Normansrule/tiqora-skywater130/docs/HARDENING.md

# Hardening Tiqora

Everything in this file is work that has to happen on your machine, because
it needs the SkyWater sky130 process design kit (PDK) and a full
place-and-route flow. Simulation and lint are done; this is the part that
turns register-transfer level (RTL) code into a layout.

Order matters. Do not skip to step 4.

---

## What is already known, so you can check the tools against it

| Quantity | Value | Where it came from |
|---|---|---|
| Flip-flops | **1,191** flattened | `yosys -s syn/synth_check.ys`, exact (main 3684851, Yosys 0.33, 2026-10-27) |
| Generic cells before technology mapping | 7,416 | same run |
| Latches inferred | **0** | the `select -assert-none t:$dlatch` in that script |
| Self-checking simulation assertions | 495 in 18 suites, all passing | `cd test && make sim` (main 3684851, 2026-10-27) |
| Verilator `-Wall` | clean | `cd test && make lint` |

If your synthesis run disagrees with the flip-flop count by more than a few,
something is different about your setup and it is worth understanding before
you continue.

---

## Step 0 — versions, because this is where the time goes

```bash
yosys -V          # any version works
verilator --version
iverilog -V | head -1
```

Any Yosys will do. The RTL deliberately avoids both typedef'd enums on
ports and file-scope `import`, referring to package symbols as
`tp_pkg::NAME` instead, which every Yosys back to 0.33 parses. That was
not free — it means writing the prefix everywhere — but it removes a
whole class of "works on my machine" failure. If you want a newer Yosys
anyway:

```bash
pip install --break-system-packages yowasp-yosys
yowasp-yosys -V
# then substitute yowasp-yosys wherever this file says yosys
```

This is not a quirk of this project. Yosys's native Verilog frontend passes
roughly half of a standard SystemVerilog construct suite. The RTL here was
deliberately written to stay inside what it accepts — no typedef'd enums or
packed structs on ports or in declarations — precisely so you are not forced
to depend on the `yosys-slang` plugin being present in someone else's
continuous integration. If you ever add a `typedef enum` port to this
design, it will simulate perfectly and then fail to harden.

---

## Step 1 — prove it still passes before you spend an hour on layout

```bash
cd test
make lint         # Verilator -Wall, must be clean
make sim          # 495 checks across eighteen suites, plus the recorded tour
make area         # real sky130 area: cells, flip-flops, fit per tile size
cd ..
```

If any of those fail, stop. Hardening a broken design just gives you a
broken layout more slowly.

---

## Step 2 — install the hardening flow

Tiny Tapeout builds with LibreLane (the successor to OpenLane 2). Two ways
to get it; the container is less trouble on Windows Subsystem for Linux
(WSL2).

### Option A — Docker (recommended on WSL2)

Docker Desktop must be running on the Windows side with WSL2 integration
enabled for your distribution. Check from inside Ubuntu:

```bash
docker run --rm hello-world
```

Then:

```bash
pip install --break-system-packages librelane
```

LibreLane pulls its own container image on first run. The sky130 PDK is
fetched automatically into `~/.volare` the first time, which is a few
gigabytes and takes a while. Let it finish.

### Option B — Nix

```bash
sh <(curl -L https://nixos.org/nix/install) --daemon
# restart the shell, then
nix profile install github:efabless/librelane
```

Nix gives a reproducible toolchain and is what the LibreLane developers use.
It is also a larger initial download.

---

## Step 3 — harden the design

The Tiny Tapeout template supplies the configuration that pins your design
into a tile: the die area for the tile count, the pin placement the harness
expects, and the power straps. **Do not write your own floorplan.** Get the
template:

```bash
cd ~
git clone https://github.com/TinyTapeout/tt10-verilog-template.git tt-template
# use whichever shuttle template is current — check tinytapeout.com
```

Copy `src/`, `info.yaml`, `docs/` and `test/` from this repository over the
template's, keeping the template's `.github/`, `Makefile` and any
`*.json`/`*.tcl` configuration. Then:

```bash
cd ~/tt-template
make            # or follow the template's README; it wraps librelane
```

What actually runs, in order: Yosys synthesis, floorplanning, power
distribution network insertion, global and detailed placement, clock tree
synthesis, global and detailed routing, parasitic extraction, static timing
analysis, and finally GDSII streaming plus design-rule and
layout-versus-schematic checks.

Expect 10 to 40 minutes for a design this size.

### The easier route

Push to GitHub with Actions enabled and the Tiny Tapeout workflow does all
of this in continuous integration and publishes the GDSII, the reports and a
rendered datasheet page. Use that as the reference result and run locally
only when you need to iterate quickly or debug a failure.

---

## Step 4 — read the reports before you look at the picture

This is the step people skip. The layout renders beautifully whether or not
it meets timing.

```bash
cd runs/<latest>/
```

**Area and utilisation** — `reports/synthesis/*stat*.rpt` and the
floorplan log. What you want:

- The standard cell count and total cell area in µm².
- The core utilisation percentage. Above roughly 60–70% on a tile, detailed
  routing starts failing.

Compare the flip-flop count against the 1,191 this repository measured. It
should match closely; a large difference means a configuration difference.

**Timing** — `reports/signoff/*sta*.rpt` or the `openroad` STA logs. Look
for:

- **Worst negative slack (WNS)** on the setup path. Must be positive at your
  target clock period. Negative means the design does not run at that speed;
  either lower `clock_hz` in `info.yaml` or shorten the critical path.
- **Total negative slack (TNS)**. Should be zero.
- **Hold slack.** Must be positive. Hold violations are not fixable by
  slowing the clock and are the more dangerous kind.

The critical path should be the one this design was built around:
register file read → the 33-bit adder in `tp_alu` → writeback multiplexer
→ register file write. If static timing reports something else as critical —
the shifter, the branch comparator, the target adder — then an assumption in
the microarchitecture section of the README is wrong and worth investigating
rather than papering over.

**Design rule check (DRC) and layout versus schematic (LVS)** — must both be
clean. Zero violations, not "a few".

**Antenna violations** — the flow inserts diodes automatically. A handful of
reported-then-fixed ones are normal.

---

## Step 5 — open the layout in KLayout

```bash
sudo apt install klayout        # or download from klayout.de for a current build
klayout runs/<latest>/final/gds/tt_um_normansrule_tiqora.gds
```

KLayout needs the sky130 layer properties file to colour the layers
meaningfully. It ships with the PDK:

```
~/.volare/sky130A/libs.tech/klayout/tech/sky130A.lyp
```

Load it with **File → Load Layer Properties**, or start KLayout with the
technology already selected:

```bash
klayout -e -nn ~/.volare/sky130A/libs.tech/klayout/tech/sky130A.lyt \
        runs/<latest>/final/gds/tt_um_normansrule_tiqora.gds
```

### What to actually look at

Opening the GDS is satisfying and mostly not informative. Four things are
worth checking with your eyes:

1. **The outline.** Your design must sit inside the tile boundary with the
   power rails reaching the edges where the harness expects them. Anything
   poking outside means a floorplan configuration mismatch.
2. **Density.** Pan around at moderate zoom. You are looking for large empty
   regions next to congested ones, which means placement struggled. Even
   density is what you want.
3. **The register file.** It is 480 flip-flops, 40% of the design, and it
   will be visible as a large regular block. If it is smeared across the
   whole tile rather than clustered, routing is probably fighting it.
4. **Routing congestion on metal 1 and metal 2.** Turn off the upper metals
   and look for areas where the lower layers are completely full.

Useful KLayout operations:

- **Tools → DRC** runs a rule deck if you load one; the flow has already
  done this, so this is for spot checks.
- **Display → Layers** to isolate a single metal layer.
- The **hierarchy browser** (left panel) lets you jump to an instance by
  name, which is how you find `u_soc.g_cpu.u_core.u_rf`.
- **Edit → Layer → Flatten** only on a copy; never flatten the file you plan
  to submit.

### Measuring the area yourself

In KLayout, **Tools → Measure** gives you the bounding box. Compare against
the tile pitch: sky130 tiles are about 161 µm by 112 µm for 1x1, a 2x2
is roughly 335 µm by 226 µm, and Tiqora's 3x2 is 508.76 µm by 225.76 µm. If your design's bounding box is comfortably
inside, consider whether a smaller tile count would have fit — each step
down is real money.

---

## Step 6 — gate-level simulation

The flow writes a post-layout netlist. Simulating it catches things RTL
simulation cannot: an inverted reset, a synthesis mis-optimisation, a
timing-dependent bug.

```bash
# the netlist is usually at:
runs/<latest>/final/nl/tt_um_normansrule_tiqora.nl.v
```

Run the cocotb tests against it. They drive the chip only through its pins,
so they work on any netlist:

```bash
cp runs/<latest>/final/nl/tt_um_normansrule_tiqora.nl.v test/gate_level_netlist.v
cd test && make GATES=yes PDK_ROOT=~/pdk
```

This is exactly what Tiny Tapeout's `test` workflow does with the hardened
netlist. Before hardening, `make gl` does the same with a netlist synthesized
locally from your PDK: 5 tests pass and 1 (which needs internal signals) is
skipped.

---

## Step 7 — before you submit

- [ ] `make lint` clean
- [ ] `make sim` — 495 checks passing, plus the recorded tour (15)
- [ ] `make area` — area and flip-flop count as expected
- [ ] Hardening completes with no DRC and no LVS violations
- [ ] Setup worst negative slack positive at the clock in `info.yaml`
- [ ] Hold slack positive
- [ ] `tiles` in `info.yaml` matches what actually fit
- [ ] Gate-level tests passing (`make gl` locally, `make GATES=yes` on the post-layout netlist)
- [ ] `docs/info.md` describes what the chip really does
- [ ] Pinout in `info.yaml` matches `src/tt_um_normansrule_tiqora.sv`

That last one is worth double-checking by hand. The pinout in `info.yaml` is
what gets printed on the datasheet other people read; nothing checks it
against the RTL.

---

## If it does not fit

The flip-flop budget, by module (Yosys, hierarchy kept; 1,190 in total):

| Module | Flip-flops | Share |
|---|---:|---:|
| `tp_nregfile` (15 × 32-bit registers) | 480 | 40% |
| `tp_ncore` | 147 | 12% |
| `qspi_ctrl` | 120 | 10% |
| `sync_compare` (2 channels) | 114 | 10% |
| `sync_timebase` | 81 | 7% |
| `sync_event_fifo` (2 entries) | 70 | 6% |
| `sync_unit` | 60 | 5% |
| `tp_uart` | 60 | 5% |
| `tp_periph` | 28 | 2% |
| `sync_capture` (8 channels) | 24 | 2% |
| `tp_soc`, `tp_bus` | 6 | 1% |

Knobs, all parameters of `tp_soc`, cheapest first:

1. **`FRACW` from 24 to 16**: 8 flip-flops, and the rate trim resolution goes
   from 0.06 to 15 parts per million. Only worth it if you are not
   disciplining the clock.
2. **`NCH` from 8 to 4 capture channels**: about 12 flip-flops plus the
   per-channel edge logic.
3. **`NCMP` from 2 to 1 trigger channel**: about 57 flip-flops. You lose TRIG1.

`DEPTH` (the event queue) is already at its useful minimum of 2. The register
file is the largest block, but RV32E fixes it at 15 registers and the stock
compilers assume all of them, so it is not a knob. If routing still fails,
the honest fix is a bigger tile: 3 × 2 costs 140 € more and leaves ample room.
