Normansrule/tiqora-skywater130/docs/images/explorer/tour.png

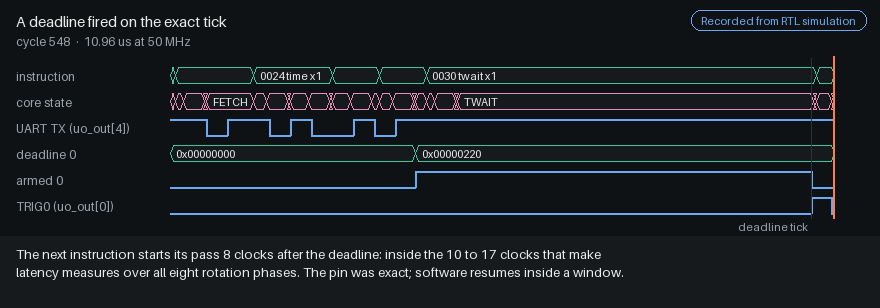
docs/images/explorer/tour.png
