Normansrule/tiqora-skywater130/docs/images/layout.png

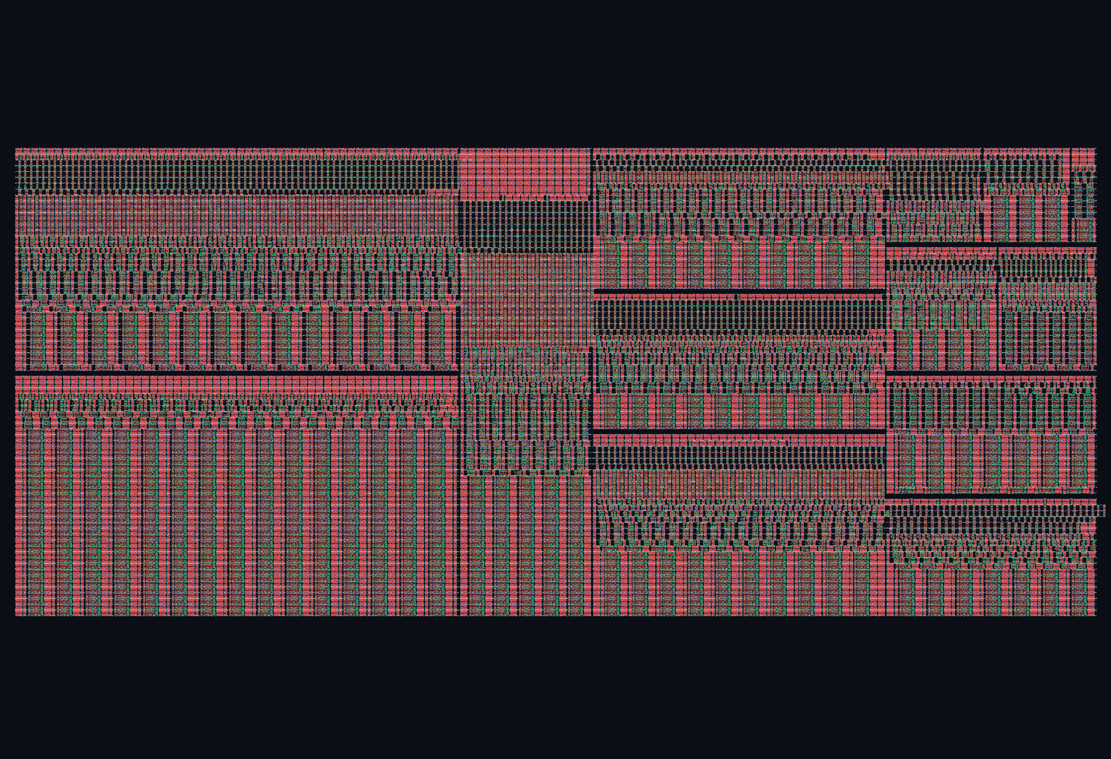
docs/images/layout.png
