Normansrule/tiqora-skywater130/docs/images/routed_clock.png

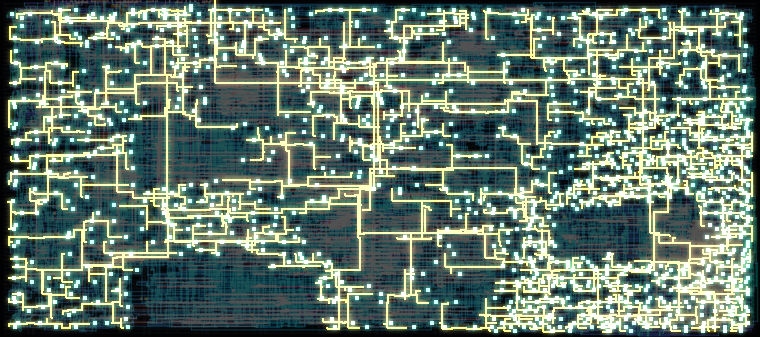
docs/images/routed_clock.png
