Normansrule/tiqora-skywater130/docs/images/zoom.webp

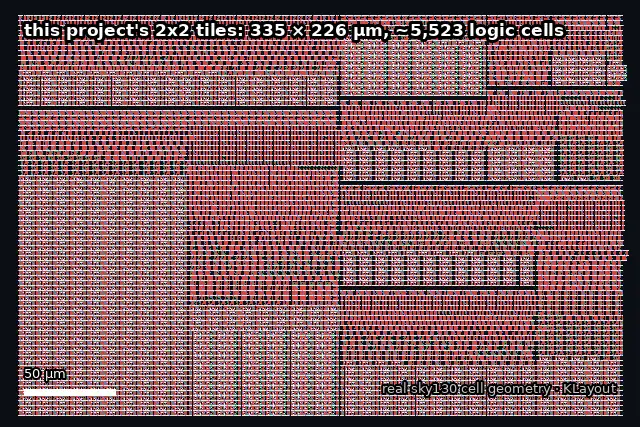
docs/images/zoom.webp
