Normansrule/tiqora-skywater130/docs/TESTING.md

# Testing everything

Every command runs from `test/` inside the repository. On Ubuntu under WSL2 with a conda
environment active, `python -m pip` installs into the environment you're in; if a later step
says a module is missing, install with `python3 -m pip` instead, since the Makefile calls `python3`.

## One-time setup

```bash
sudo apt install iverilog verilator yosys          # simulator, linter, synthesis
python -m pip install cocotb pytest ziglang pyelftools
```

`ziglang` provides the C compiler (Clang, targeting RV32E) and `pyelftools` reads the compiled
programs. A sky130 PDK (for `make area`, `make timing` and `make gl`) is expected at `~/pdk/sky130A`;
point elsewhere with `PDK_ROOT=` or `LIB=`.

## The everyday run — about 5 minutes

```bash
cd ~/tiqora-skywater130/test
make sim        # all eighteen self-checking suites, 495 checks (230 of them the CPU/GPU/TPU modes), plus the docs and shared-file checks
make            # the cocotb tests, from the pins only (6 tests)
make lint       # Verilator -Wall, no waivers
make warnings   # lint, plus Yosys synthesis with zero warnings (needs Yosys; not in CI)
```

Each testbench ends with a line like `51 checks, 0 failures`, and `make sim` stops with an error at the first bench that reports a failure (`test/vv.sh` turns the verdict into an exit status; before 2026-10-25 a failing bench still let `make` succeed). `make sim` covers:

| Bench | Checks | What it proves |
|---|---:|---|
| unit | 50 | timing-unit blocks, rotating register file (including 4,000 random clocks against a model, every phase), UART, GPIO |
| soc | 12 | boots, arms a deadline, the trigger lands on the exact tick |
| isa | 51 | every RV32E base instruction vs Python-computed results |
| stress | 18 | 8 simultaneous captures, queue overflow, 2³² rollover |
| wrap | 10 | `TWAIT` across the timebase rollover |
| xpulse | 15 | all eleven timing instructions |
| boot | 14 | the UART bootloader, end to end, with RAM timing checked; a RAM program re-enters it by jumping to 0x4000_0000 with hostile registers, then a second program loads |
| wake | 14 | the chip wakes the flash and RAM from cold, warm and pre-set states |
| c | 12 | a Clang-compiled C program from flash and via the bootloader |
| mcu | 16 | the chip as a microcontroller: C from flash, a host on the UART, pins, trigger tick, capture timestamp, RAM |
| bridge | 10 | the demo-board bridge vs a simulated chip with jitter and clock error |
| printf | 23 | `tp_printf`, character for character against Python's `%` formatting |
| spi | 2 | the software SPI reads a simulated W25Q128 flash's JEDEC ID (`EF 40 18`) |
| readme | 10 | the README's minimal program, compiled verbatim, from flash and RAM, checked at the pins |
| latency | 1 | software resumes 10–17 clocks after a `TWAIT` deadline, on all 8 rotation phases |
| adjust | 3 | a time step neither skips nor repeats a deadline |
| shared | 7 files | the timing unit and its reference model match Tiqora-Serial's, by SHA-256 manifest |
| syncref | 4 | the timing unit against a Python reference model (`test/sync_model.py`), every output on every clock, 60,000 random clocks in each of three builds (Tiqora, Tiqora-Serial and a small stress build), and no pin event lost without overflow |

**Two event-loss bugs the reference model found, fixed 2026-10-26.** The
timing unit promises that every pin event is either queued or counted by the
sticky overflow flag. The model found two ways it broke that promise, and the
fourth `make syncref` check now holds it:

* **A backlog replaced.** Edges on several channels in one clock are queued
  one per clock, lowest channel first, from a backlog. A new edge before that
  backlog drains replaces it. The events still waiting are dropped, and that
  now raises overflow (`backlog_lost` in `src/sync/sync_unit.sv`). Both chips.
* **A TMARK collision.** The queue takes one word per clock. When a `TMARK`
  and a pin event arrive in the same clock, the mark takes the slot; the pin
  event now stays in the backlog and is queued a clock later with its own
  timestamp, instead of being dropped. Tiqora only (Tiqora-Serial ties its
  Xpulse port off).

The fix costs 52 cells, 85 µm² on Tiqora (`make area`, 50,880 to 50,965 µm²).
Five mutants of it are each caught by `make syncref`, the overflow input by
`make unit`, and the backlog case on Tiqora-Serial by its `tb_proto.sv`.

## Measuring speed

```bash
make run PROG=../sw/examples/bench_kernel.c RUNARGS=+PROFILE   # clocks per state, fetch lengths, instruction mix
make run PROG=../sw/examples/bench_alu.c RUNARGS=+PROFILE      # the best case: straight-line ALU code
```

## Run your own program on the simulated chip

```bash
make run PROG=../sw/examples/hello.c              # or any C file of yours
```

## The deeper checks

```bash
make act        # the official RISC-V architecture tests: 37/37 RV32E, about 10 minutes
make gl         # synthesize to sky130 gates and rerun the cocotb tests on the netlist
make area       # real cell area against the sky130 library (expect ~49,186 µm²)
make timing     # critical-path estimate from real cell delays (expect ~6.9 ns vs 20 ns)
```

`make act` downloads the suite the first time (`act/fetch.sh`) and prints one line per
instruction, ending in `37 of 37 official RV32E tests pass`.

## The software side

```bash
python3 ../sw/tpload.py selftest                  # the PC-side UART loader, 7 checks
python3 ../sw/demoboard/test_tpboot.py            # the demo-board bridge, 10 checks (also in make sim)
cd ../sw && make TOOLCHAIN=zig && make TOOLCHAIN=zig RAM=1    # build the example for flash and RAM
```

## Regenerating the images

```bash
cd ~/tiqora-skywater130
python3 docs/tools/figures.py                      # pinout, block diagram, scale
python3 docs/tools/animations.py                   # the animated diagrams
python3 -m pip install klayout pillow
python3 docs/tools/layout_preview.py ~/pdk/sky130A/libs.ref/sky130_fd_sc_hd    # cell-level layout
python3 docs/tools/zoom_animation.py               # the tile-to-transistor zoom
python3 docs/tools/datasheet_stills.py              # three stills of the zoom for the PDF datasheet
python3 docs/tools/exploded_cell.py ~/pdk/sky130A/libs.ref/sky130_fd_sc_hd     # the exploded flip-flop
python3 docs/tools/build_explorer.py               # the interactive explorer page
python3 docs/tools/atlas.py                        # the explorer site's chip atlas (needs Yosys)
python3 docs/tools/traces.py                       # its tours, from make -C test tour
python3 docs/tools/motion.py                       # every tour as an animation (before build_site.py)
python3 docs/tools/build_site.py                   # its pages, docs/site/*.html
python3 docs/tools/readme_media.py                 # the README animation
python3 docs/tools/silicon_views.py                # pin map at real positions, packaging, connections
```

## On an FPGA

```bash
make -C ../fpga/basys3 sim         # the whole Basys 3 design, four runs: 26 checks, then the modes transcript against sw/modes_model.py
make -C ../fpga/basys3 resources   # Yosys estimate for the XC7A35T (needs a Yosys with synth_xilinx)
make -C ../fpga/basys3 bit prog    # Vivado: build and load the bitstream
```

See [fpga/basys3/README.md](../fpga/basys3/README.md).

## Tiny Tapeout's own pre-flight check

The `gds` workflow starts by running Tiny Tapeout's project checker. You can run the same
checker first, in its own Python environment (its pinned packages would otherwise change your
conda environment):

```bash
python3 -m venv ~/tt-venv && . ~/tt-venv/bin/activate
cd ~/tiqora-skywater130
git clone --depth 1 https://github.com/TinyTapeout/tt-support-tools tt
pip install -r tt/requirements.txt
python tt/tt_tool.py --check-docs            # expect: Documentation check passed successfully.
python tt/tt_tool.py --create-user-config    # expect: creating include file (reads every source with CI's Yosys)
deactivate
```

Both pass. `tt/` and the generated `src/user_config.json` are git-ignored; CI makes its own.

## A note on test builds

Every test compiles C from scratch in a private, freshly wiped cache. Zig's build cache judges
whether a header changed partly by its timestamp, and during mutation testing a source that was
broken and restored within the same second was once built from the stale broken version. A test
result has to come from the code on disk, so the tests never trust a cache.

## After pushing to GitHub

The `gds` workflow hardens the design with the full Tiny Tapeout flow (LibreLane). When it
succeeds, the `viewer` job publishes the real routed layout to GitHub Pages — enable
**Settings → Pages → Source: GitHub Actions** once — at:

- `https://normansrule.github.io/tiqora-skywater130/gds_render.png` (image)
- `https://normansrule.github.io/tiqora-skywater130/` (opens the 3D viewer)

The `test` workflow runs the cocotb tests on the post-layout netlist. Its routing and timing
reports are the final word on whether the design fits and meets 50 MHz.
