Normansrule/tiqora-skywater130/MAINTAINERS.md

# Maintainers

| Maintainer | Role |
|---|---|
| [@Normansrule](https://github.com/Normansrule) (Aleksander J. Norman) | sole maintainer: reviews and merges every change, owns releases and Tiny Tapeout submissions |

`.github/CODEOWNERS` assigns every file to @Normansrule, so GitHub asks for their review on
every pull request.

Questions, bug reports and proposals go to this repository's GitHub issues. Pull requests
are welcome; the maintainer reviews them, and authors of merged work keep their credit in
the commit history.

## Credits

The nibble-serial approach follows [TinyQV](https://github.com/MichaelBell/tinyQV) by Michael Bell. The sky130 PDK is by SkyWater and Google; fabrication would be through [Tiny Tapeout](https://tinytapeout.com). The RISC-V architecture tests are from [riscv-arch-test](https://github.com/riscv-non-isa/riscv-arch-test) and keep their own licence. See [docs/REFERENCES.md](docs/REFERENCES.md).

The commit history is kept as it was written. Nothing in it has been rewritten to change who
appears as an author.
