Normansrule/tiqora-skywater130/fpga/basys3/basys3.xdc

# basys3.xdc — Tiqora on the Digilent Basys 3.
# Pin locations from Digilent's Basys-3-Master.xdc (github.com/Digilent/digilent-xdc).

set_property -dict { PACKAGE_PIN W5 IOSTANDARD LVCMOS33 } [get_ports {clk}]
set_property -dict { PACKAGE_PIN U18 IOSTANDARD LVCMOS33 } [get_ports {btnC}]
set_property -dict { PACKAGE_PIN W19 IOSTANDARD LVCMOS33 } [get_ports {btnL}]
set_property -dict { PACKAGE_PIN T17 IOSTANDARD LVCMOS33 } [get_ports {btnR}]
set_property -dict { PACKAGE_PIN T18 IOSTANDARD LVCMOS33 } [get_ports {btnU}]
set_property -dict { PACKAGE_PIN B18 IOSTANDARD LVCMOS33 } [get_ports {RsRx}]
set_property -dict { PACKAGE_PIN A18 IOSTANDARD LVCMOS33 } [get_ports {RsTx}]
set_property -dict { PACKAGE_PIN V7 IOSTANDARD LVCMOS33 } [get_ports {dp}]
set_property -dict { PACKAGE_PIN V17 IOSTANDARD LVCMOS33 } [get_ports {sw[0]}]
set_property -dict { PACKAGE_PIN V16 IOSTANDARD LVCMOS33 } [get_ports {sw[1]}]
set_property -dict { PACKAGE_PIN W16 IOSTANDARD LVCMOS33 } [get_ports {sw[2]}]
set_property -dict { PACKAGE_PIN W17 IOSTANDARD LVCMOS33 } [get_ports {sw[3]}]
set_property -dict { PACKAGE_PIN W15 IOSTANDARD LVCMOS33 } [get_ports {sw[4]}]
set_property -dict { PACKAGE_PIN V15 IOSTANDARD LVCMOS33 } [get_ports {sw[5]}]
set_property -dict { PACKAGE_PIN W14 IOSTANDARD LVCMOS33 } [get_ports {sw[6]}]
set_property -dict { PACKAGE_PIN W13 IOSTANDARD LVCMOS33 } [get_ports {sw[7]}]
set_property -dict { PACKAGE_PIN V2 IOSTANDARD LVCMOS33 } [get_ports {sw[8]}]
set_property -dict { PACKAGE_PIN T3 IOSTANDARD LVCMOS33 } [get_ports {sw[9]}]
set_property -dict { PACKAGE_PIN T2 IOSTANDARD LVCMOS33 } [get_ports {sw[10]}]
set_property -dict { PACKAGE_PIN R3 IOSTANDARD LVCMOS33 } [get_ports {sw[11]}]
set_property -dict { PACKAGE_PIN W2 IOSTANDARD LVCMOS33 } [get_ports {sw[12]}]
set_property -dict { PACKAGE_PIN U1 IOSTANDARD LVCMOS33 } [get_ports {sw[13]}]
set_property -dict { PACKAGE_PIN T1 IOSTANDARD LVCMOS33 } [get_ports {sw[14]}]
set_property -dict { PACKAGE_PIN R2 IOSTANDARD LVCMOS33 } [get_ports {sw[15]}]
set_property -dict { PACKAGE_PIN U16 IOSTANDARD LVCMOS33 } [get_ports {led[0]}]
set_property -dict { PACKAGE_PIN E19 IOSTANDARD LVCMOS33 } [get_ports {led[1]}]
set_property -dict { PACKAGE_PIN U19 IOSTANDARD LVCMOS33 } [get_ports {led[2]}]
set_property -dict { PACKAGE_PIN V19 IOSTANDARD LVCMOS33 } [get_ports {led[3]}]
set_property -dict { PACKAGE_PIN W18 IOSTANDARD LVCMOS33 } [get_ports {led[4]}]
set_property -dict { PACKAGE_PIN U15 IOSTANDARD LVCMOS33 } [get_ports {led[5]}]
set_property -dict { PACKAGE_PIN U14 IOSTANDARD LVCMOS33 } [get_ports {led[6]}]
set_property -dict { PACKAGE_PIN V14 IOSTANDARD LVCMOS33 } [get_ports {led[7]}]
set_property -dict { PACKAGE_PIN V13 IOSTANDARD LVCMOS33 } [get_ports {led[8]}]
set_property -dict { PACKAGE_PIN V3 IOSTANDARD LVCMOS33 } [get_ports {led[9]}]
set_property -dict { PACKAGE_PIN W3 IOSTANDARD LVCMOS33 } [get_ports {led[10]}]
set_property -dict { PACKAGE_PIN U3 IOSTANDARD LVCMOS33 } [get_ports {led[11]}]
set_property -dict { PACKAGE_PIN P3 IOSTANDARD LVCMOS33 } [get_ports {led[12]}]
set_property -dict { PACKAGE_PIN N3 IOSTANDARD LVCMOS33 } [get_ports {led[13]}]
set_property -dict { PACKAGE_PIN P1 IOSTANDARD LVCMOS33 } [get_ports {led[14]}]
set_property -dict { PACKAGE_PIN L1 IOSTANDARD LVCMOS33 } [get_ports {led[15]}]
set_property -dict { PACKAGE_PIN W7 IOSTANDARD LVCMOS33 } [get_ports {seg[0]}]
set_property -dict { PACKAGE_PIN W6 IOSTANDARD LVCMOS33 } [get_ports {seg[1]}]
set_property -dict { PACKAGE_PIN U8 IOSTANDARD LVCMOS33 } [get_ports {seg[2]}]
set_property -dict { PACKAGE_PIN V8 IOSTANDARD LVCMOS33 } [get_ports {seg[3]}]
set_property -dict { PACKAGE_PIN U5 IOSTANDARD LVCMOS33 } [get_ports {seg[4]}]
set_property -dict { PACKAGE_PIN V5 IOSTANDARD LVCMOS33 } [get_ports {seg[5]}]
set_property -dict { PACKAGE_PIN U7 IOSTANDARD LVCMOS33 } [get_ports {seg[6]}]
set_property -dict { PACKAGE_PIN U2 IOSTANDARD LVCMOS33 } [get_ports {an[0]}]
set_property -dict { PACKAGE_PIN U4 IOSTANDARD LVCMOS33 } [get_ports {an[1]}]
set_property -dict { PACKAGE_PIN V4 IOSTANDARD LVCMOS33 } [get_ports {an[2]}]
set_property -dict { PACKAGE_PIN W4 IOSTANDARD LVCMOS33 } [get_ports {an[3]}]
set_property -dict { PACKAGE_PIN J1 IOSTANDARD LVCMOS33 } [get_ports {JA[0]}]
set_property -dict { PACKAGE_PIN L2 IOSTANDARD LVCMOS33 } [get_ports {JA[1]}]
set_property -dict { PACKAGE_PIN J2 IOSTANDARD LVCMOS33 } [get_ports {JA[2]}]
set_property -dict { PACKAGE_PIN G2 IOSTANDARD LVCMOS33 } [get_ports {JA[3]}]
set_property -dict { PACKAGE_PIN H1 IOSTANDARD LVCMOS33 } [get_ports {JA[4]}]
set_property -dict { PACKAGE_PIN K2 IOSTANDARD LVCMOS33 } [get_ports {JA[5]}]
set_property -dict { PACKAGE_PIN H2 IOSTANDARD LVCMOS33 } [get_ports {JA[6]}]
set_property -dict { PACKAGE_PIN G3 IOSTANDARD LVCMOS33 } [get_ports {JA[7]}]

create_clock -period 10.000 -name sys_clk [get_ports clk]
# Tiqora runs at 50 MHz, from a divide-by-two flip-flop
create_generated_clock -name clk50 -source [get_ports clk] -divide_by 2 [get_pins clk_div_reg/Q]

# Pmod chip selects idle high while Tiqora releases the pins in reset
set_property PULLUP true [get_ports {JA[0]}]
set_property PULLUP true [get_ports {JA[6]}]
set_property PULLUP true [get_ports {JA[7]}]
# buttons, switches and the UART are asynchronous; Tiqora synchronizes its inputs itself
set_false_path -from [get_ports {btnC btnL btnR btnU RsRx sw[*]}]
set_false_path -to [get_ports {led[*] seg[*] an[*] dp RsTx}]

set_property CONFIG_VOLTAGE 3.3 [current_design]
set_property CFGBVS VCCO [current_design]
set_property BITSTREAM.GENERAL.COMPRESS TRUE [current_design]
