Normansrule/tiqora-skywater130/sw/tinypulse.h

// tinypulse.h — legacy name. Tiqora was called TinyPulse until October 2026.
// Existing programs keep compiling unchanged; new code should include tiqora.h.
// The API itself (tp_time, tp_wait, tp_arm, ... and the TP_* macros) is unchanged.
#include "tiqora.h"
