Normansrule/tiqora-skywater130/test/tb_boot.sv

// tb_boot.sv — the UART bootloader, end to end, from the pins.
//
// The testbench plays the PC on the far side of a USB-UART bridge:
//   hold ui_in[7] high through reset  -> the core starts in the boot ROM
//   expect "TP>" on uo_out[4]
//   send a 4-byte length and the hello-world program on ui_in[3]
//   expect the checksum byte and 'K'
//   expect the program, now running from RAM, to print "Hi Tiqora\n"
//
// Before that, the same route loads test/reenter.hex (sw/mkreenter.py): a
// program that fills the bootloader's registers with hostile values and
// jumps back to 0x4000_0000 with no reset. The hello-world load above then
// goes through that re-entered bootloader, so it also proves warm entry.
//
// The UART divider is overridden to 64 clocks per bit so this runs in
// seconds; on silicon it is 434 (115,200 baud at 50 MHz). Each received byte
// costs the bootloader about 150 clocks (eight nibble-serial instructions and
// a QSPI RAM write), so at 434 there is a 25x margin; at 16 there would be
// none, and bytes would overrun.
`default_nettype none
`timescale 1ns/1ps

module tb_boot;
    localparam int DIV = 64;   // 640 clocks per byte: slower than this and the loop has margin
    reg        clk = 1'b0, rst_n = 1'b0, ena = 1'b1;
    reg  [7:0] ui_in = 8'h88;               // ui[7] = boot strap, ui[3] = RX idle high
    wire [7:0] uo_out, uio_out, uio_oe;
    integer errors = 0, checks = 0;
    always #5 clk = ~clk;

    wire sck  = uio_out[3];
    wire cs_f = uio_out[0];
    wire cs_r = uio_out[6];
    wire [3:0] flash_sd, psram_sd;
    wire [3:0] sd_bus = uio_oe[1] ? {uio_out[5], uio_out[4], uio_out[2], uio_out[1]}
                      : (!cs_f ? flash_sd : (!cs_r ? psram_sd : 4'hF));
    wire [7:0] uio_in = {2'b00, sd_bus[3], sd_bus[2], 1'b0, sd_bus[1], sd_bus[0], 1'b0};

    tt_um_normansrule_tiqora dut (
        .ui_in(ui_in), .uo_out(uo_out), .uio_in(uio_in),
        .uio_out(uio_out), .uio_oe(uio_oe), .ena(ena), .clk(clk), .rst_n(rst_n));
    defparam dut.u_soc.u_periph.DIV_RESET = DIV;

    qspi_flash_model #(.DUMMY(4), .WORDS(64)) u_flash (
        .cs_n(cs_f), .sck(sck), .ctrl_sd({uio_out[5], uio_out[4], uio_out[2], uio_out[1]}), .dev_sd(flash_sd));
    qspi_psram_model #(.DUMMY(6), .BYTES(4096)) u_psram (
        .cs_n(cs_r), .sck(sck), .ctrl_sd({uio_out[5], uio_out[4], uio_out[2], uio_out[1]}), .dev_sd(psram_sd));

    task chk(input cond, input [8*72:1] msg);
        begin
            checks = checks + 1;
            if (cond) $display("  ok    %0s", msg);
            else begin errors = errors + 1; $display("  FAIL  %0s", msg); end
        end
    endtask

    // ---- the host's UART ----
    task host_send(input [7:0] b);
        integer i;
        begin
            ui_in[3] = 1'b0; repeat (DIV) @(posedge clk);
            for (i = 0; i < 8; i = i + 1) begin ui_in[3] = b[i]; repeat (DIV) @(posedge clk); end
            ui_in[3] = 1'b1; repeat (DIV) @(posedge clk);
        end
    endtask

    task host_recv(input integer div, output [7:0] b);
        integer i, t;
        begin
            t = 0;
            while (uo_out[4] !== 1'b0) begin
                @(posedge clk); t = t + 1;
                if (t > 200000) begin $display("  FAIL  timed out waiting for a byte"); errors = errors + 1; $finish; end
            end
            repeat (div / 2) @(posedge clk);
            for (i = 0; i < 8; i = i + 1) begin repeat (div) @(posedge clk); b[i] = uo_out[4]; end
            repeat (div) @(posedge clk);
        end
    endtask

    reg  [31:0] image [0:127];

    // Warm-entry evidence: the core ran from RAM, and rst_n rose only once.
    reg     ran_from_ram = 1'b0;
    integer resets = 0;
    always @(posedge rst_n) resets = resets + 1;
    always @(posedge clk) if (rst_n && dut.u_soc.g_cpu.u_core.pc[31:28] == 4'h1) ran_from_ram = 1'b1;

    // Read a hex program into `image`; returns its length in words.
    task load_hex(input [8*16:1] fname, output integer n);
        integer j;
        begin
            for (j = 0; j < 128; j = j + 1) image[j] = 32'hxxxx_xxxx;
            $readmemh(fname, image);
            n = 0;
            while (n < 128 && image[n] !== 32'hxxxx_xxxx) n = n + 1;
        end
    endtask

    // Send `image` as the bootloader expects it; returns the byte sum.
    task send_image(input integer n, output integer s);
        integer j, m;
        reg [31:0] v;
        begin
            for (m = 0; m < 4; m = m + 1) host_send((4 * n) >> (8 * m));
            s = 0;
            for (j = 0; j < n; j = j + 1) begin
                v = image[j];
                for (m = 0; m < 4; m = m + 1) begin
                    host_send(v[8*m +: 8]);
                    s = s + v[8*m +: 8];
                end
            end
        end
    endtask

    integer     nwords, i, k, sum;
    reg  [7:0]  b, got_sum, got_k;
    reg  [8*16:1] banner, text;
    reg  [31:0] w;

    initial begin
        $dumpfile("tb_boot.vcd");
        $dumpvars(0, tb_boot);
        $display("\n=== Tiqora UART bootloader ===");
        repeat (10) @(posedge clk);
        rst_n = 1'b1;

        // ---- first load: reenter.hex, which jumps back into the boot ROM ----
        load_hex("reenter.hex", nwords);
        $display("  first program: reenter.hex, %0d bytes, sent at %0d clocks per bit", 4 * nwords, DIV);
        banner = 0;
        for (k = 0; k < 3; k = k + 1) begin host_recv(DIV, b); banner = {banner[8*15:1], b}; end
        chk(banner[24:1] == "TP>", "after reset: boot ROM announces itself with TP>");
        send_image(nwords, sum);
        host_recv(DIV, got_sum);
        host_recv(DIV, got_k);
        chk(got_sum == sum[7:0] && got_k == "K", "first program loaded: checksum and K");

        // ---- second load, through the re-entered bootloader ----
        load_hex("hello.hex", nwords);
        $display("  second program: hello.hex, %0d bytes, after a jump to 0x4000_0000 with no reset", 4 * nwords);
        banner = 0;
        for (k = 0; k < 3; k = k + 1) begin host_recv(DIV, b); banner = {banner[8*15:1], b}; end
        chk(banner[24:1] == "TP>", "re-entered by a jump: TP> again, with dirty registers");
        chk(dut.u_soc.g_cpu.u_core.pc[31:28] == 4'h4, "the core is executing from the boot ROM");

        chk(ran_from_ram && resets == 1, "re-entry came from the RAM program, with no second reset");
        // length, little endian, then the bytes
        send_image(nwords, sum);

        chk(dut.u_soc.u_periph.u_uart.rx_overrun === 1'b0, "no byte overran the bootloader while loading");
        host_recv(DIV, got_sum);
        host_recv(DIV, got_k);
        chk(got_sum == sum[7:0], "checksum byte matches what was sent");
        chk(got_k == "K", "bootloader acknowledges with K");

        begin : ram_check
            integer bad;
            bad = 0;
            for (i = 0; i < nwords; i = i + 1)
                if ({u_psram.mem[4*i+3], u_psram.mem[4*i+2], u_psram.mem[4*i+1], u_psram.mem[4*i]} !== image[i])
                    bad = bad + 1;
            chk(bad == 0, "RAM A holds the program byte for byte");
        end

        // the loaded program switches the UART to 8 clocks per bit and prints
        text = 0;
        // count derived from the expected text, never hard-coded: a rename once
        // shortened the greeting and a fixed count waited for bytes never sent
        begin : greeting
            string want; string got;
            want = "Hi Tiqora\n"; got = "";
            for (k = 0; k < want.len(); k = k + 1) begin host_recv(8, b); got = {got, string'(b)}; end
            chk(got == want, "the loaded program runs from RAM and prints its greeting");
            $display("        it said: \"%0s\"", got.substr(0, got.len() - 2));
        end

        k = 0;
        while (!dut.u_soc.g_cpu.u_core.halted && k < 20000) begin @(posedge clk); k = k + 1; end
        chk(dut.u_soc.g_cpu.u_core.halted === 1'b1, "the loaded program ran to its ECALL");
        chk(dut.u_soc.g_cpu.u_core.pc[31:28] == 4'h1, "and it halted at an address in RAM (0x1xxx_xxxx)");
        chk(dut.u_soc.g_cpu.u_core.illegal_q === 1'b0, "no illegal instructions anywhere along the way");
        chk(u_psram.violations == 0, "RAM timing: selected under 8 us, deselected at least 18 ns, always");

        $display("\n%0d checks, %0d failures", checks, errors);
        if (errors == 0) $display("BOOTLOADER TEST PASSED\n");
        else             $display("BOOTLOADER TEST FAILED\n");
        $finish;
    end
endmodule
