Normansrule/tiqora-skywater130/(commit log)

2026-10-18 v20 build: CPU/GPU/TPU modes (FPGA and full chip), README progress tracker, Basys 3 fixes, tile identity check
    [check_modes_demo.py, mkmodes.py, modes_demo.c, modes_model.py, package_view.py, qspi_emu.sv, rv32e_check.py, strip_cells.py]
2026-10-18 v20: rename to Tiqora, fix README GPIO_SEL example, instruction prefetch
    [adjust_cross.c, animations.py, basys3.xdc, basys3_demo.c, basys3_top.sv, bench_alu.c, bench_kernel.c, build_explorer.py]
2026-10-19 Maintainer files: CODEOWNERS (* @Normansrule), MAINTAINERS.md, .mailmap
    CODEOWNERS asks GitHub to request the maintainer's review on every change; it
    grants no access and removes none. MAINTAINERS.md separates current access,
    ownership and historical credit, and records the 2026-10-18 access audit (one
    collaborator, no invitations, keys or webhooks). .mailmap maps the template
    placeholder identities on earlier commits ("your GitHub email", "Your Name
    <you@example.com>") to Aleksander J. Norman for tools that read it; history
    is not rewritten.
2026-10-22 Explorer redesign: opening shot, big numbers, die zoom from a salt grain to one flip-flop, deadline lab, live simulated Basys 3 (make -C fpga/basys3 record)
    [layout_preview.py, mktour.py, tb_tour.sv, traces.py]
2026-10-23 Animated recordings in the README and explorer; publish the explorer to GitHub Pages
    - docs/tools/motion.py (shared, in docs/shared_explorer.sha256): every recorded
    tour in docs/site/data/traces becomes a CSS-animated SVG in docs/images/motion/.
    A cursor sweeps the window caption by caption; with reduced motion (or no CSS)
    each file is a still of the whole recording with the tour's summary.
    `motion.py --check` runs in `make -C test docs`.
    - README: the animations sit next to the sections they show; explorer links point
    at GitHub Pages, with the htmlpreview link kept as a fallback.
    - Explorer Overview: a "Watch it run" section inlines every reel, with a pause button.
    - .github/workf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
2026-10-24 Link the project website from the README and every page; phone header
    - README: a prominent "Open the project website" link under the title.
    - Site header: a GitHub source link beside the theme switch; on phones the
    page links become one sideways-scrolling row with the current page in view,
    instead of a column that pushed the content down.
    - Site head: favicon (the tile mark), theme-color, Open Graph tags from the
    new site.json "url"; footer links the sibling chip ("sibling").
    - Overview hero: the evidence labels wrap as one group; eyebrow and note
    centred under long titles.
    Shared files (build_site.py, exhibit.css) are byte-identical in both repos;
    docs/shared_explorer.sha256 updat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
2026-10-25 Audits: make sim fails on a failed check; warm-entry and register-rotation checks
    - test/vv.sh: vvp exits 0 after $finish even when checks failed, so
    `make sim` succeeded with FAIL lines in its output (measured: a broken
    boot ROM gave make exit 0). The ten self-checking iverilog benches now run
    through vv.sh, which fails unless vvp succeeded, no line reports FAIL and
    the bench printed its PASSED line.
    - Warm entry (sw/mkreenter.py, test/tb_boot.sv): a RAM program fills the
    bootloader's registers with hostile values and jumps to 0x4000_0000 with
    no reset; the hello-world load then goes through the re-entered
    bootloader. boot: 11 -> 14 checks. Mutants (drop sum=0, length=0, shift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
    [mkreenter.py, tb_boot.sv, tb_unit.sv]
2026-10-25 Area and timing: synthesize with the cells the real flow may use
    LibreLane synthesizes with the PDK's no_synth.cells excluded (185 cells,
    most of the smallest drive strengths). make area, make timing and
    atlas.py used the full library, so they reported area the flow cannot
    reach. syn/dont_use.py marks those cells dont_use in a staged library
    copy; it exits 2 if the list is missing and 3 if it marks nothing
    (mutant that marks nothing: make area exit 0 -> 3).
    Measured (main 2026-10-25, Yosys 0.33): Tiqora 60,750 um^2 (was 50,880),
    80% of 2x2; LibreLane 3.0.14 itself synthesizes 59,797 um^2. Logic timing
    17.04 ns ss_100C_1v60, 7.37 ns tt (was 12.65 / 6.23). Tiqora-Serial
    25,033 um^2 (was 21,32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
2026-10-25 Move Tiqora to 3x2 tiles with placement density 50
    At 2x2 the cells now fit, but routing needs 153% of the routing tracks
    (local LibreLane 3.0.14), and GitHub's gds job hit the 6-hour limit. At
    3x2 with the default packing (72) the cells stay clustered and detailed
    routing stalls near 6,600 violations; at 50 global routing uses 52% of
    the tracks and detailed routing reaches 0 violations locally.
    Claude-Session: https://claude.ai/code/session_01ADWnr1PnKKjPLfkHcRqLMM
2026-10-25 make mcu: the chip used as a microcontroller, end to end
    sw/examples/mcu_e2e.c runs from flash and holds a conversation with
    test/tb_mcu.sv as the host: UART both ways (a line echoed upper-cased),
    input pins read, output pins set/toggle/clear, a trigger armed from C
    rising on the exact tick with the requested width, an input edge
    timestamped with the fixed 3-tick latency, a software mark, 1 KB of RAM,
    and a clean halt. 16 checks; 8 of 8 RTL mutants caught (trigger one tick
    late, pulse width +1, GPIO XOR as OR, GPIO CLR inverted, input pins
    shifted, UART RX bit flipped, capture timestamp +1, mark timestamp -1).
    make sim: 490 checks in 17 suites plus tour 15, cocotb 6/6.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
    [mcu_e2e.c, tb_mcu.sv]
2026-10-25 Docs, figures and site for the 3x2 layout; area tools use src/synth_exclude.cells
    PR #4 (merged into this branch) moves Tiqora to 3x2 tiles at placement
    density 50 and lets synthesis use the drive-strength-1 cells. GitHub run
    40213473443: gds, precheck and gl_test pass.
    - syn/dont_use.py reads src/synth_exclude.cells when the repository has
    one, so make area, make timing and atlas.py model the flow's own cell
    list: 50,880 um^2, 44% of 3x2; logic timing 12.57 ns ss / 6.17 ns tt
    before wires (Yosys 0.33). Modes build 70,679 um^2, 62% of 3x2.
    - tile_template.json, pin map, scale figure, layout preview, die map and
    per-block area redrawn for the 508.76 x 225.76 um die.
    - README, datashe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
2026-10-26 Mark small arrays as registers to clear Yosys warnings
    Yosys warned "Replacing memory ... with list of registers" for
    sync_compare.sv (deadline, pulse_cnt) and, in Tiqora, tp_nregfile.sv (r).
    That conversion is what we want; (* mem2reg *) asks for it explicitly, so
    synthesis is now warning-free. The sky130 gate netlist is byte-identical
    (syn/tile_identity.sh HEAD: 6047 cells, same sha256) and Serial's Yosys
    stat is unchanged. The shared timing manifest, traces, atlas and site
    pages are regenerated for the new source hashes.
    Claude-Session: https://claude.ai/code/session_01ULLxNMnJM4TcF42NryJyhQ
2026-10-26 Add make warnings: Verilator and Yosys must both be silent
    `make warnings` runs `make lint` (Verilator -Wall) and then Yosys
    synthesis, and fails if Yosys prints any warning. It is part of `make sim`.
    Mutations: dropping (* mem2reg *) from sync_compare.sv fails it (Yosys),
    and an unused signal fails it (Verilator UNUSEDSIGNAL); 2 of 2 caught.
    syn/stat.txt, written by the synthesis script, is now ignored.
    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
2026-10-26 Show Tiqora's real routed 3x2 layout: glowing hero, explorer, clock edge
    routed.json from a local LibreLane 3.0.14 run of the 3x2 configuration,
    routed clean (0 detailed-routing violations) with GRT_ADJUSTMENT 0.15:
    the default 0.3 stalled locally at 3 violations, while GitHub's run of
    src/config.json routes at the default. The pages and README say so.
    15,606 cells (8,482 working), 54,833 wire segments, clock tree 117 nets
    in 4 levels reaching all 1,191 flip-flops. README gets the routed still,
    the clock-edge GIF and its still, and a refreshed opening-shot picture.
    The no-JavaScript physical page shows the still in place of the explorer.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
2026-10-26 Route Tiqora 3x2 without stalls and report its routed timing
    Locally, detailed routing at 3x2 ground on its last 3 to 17 shorts for
    hours: global routing held back 30% of the tracks and ended with 58
    overflows. Lowering the placement target cannot help (GPL-0302 clamps it
    at 0.5) and cell padding made it worse (8,346 overflows).
    src/config.json:
    - GRT_ADJUSTMENT 0.15: 0 global-route overflows; detailed routing ends
    with 0 violations in about 30 minutes.
    - CTS_SINK_CLUSTERING_SIZE 10: clock leaves within the fanout limit of
    10 (83 fanout warnings -> 2).
    - RUN_POST_GRT_DESIGN_REPAIR, RUN_POST_GRT_RESIZER_TIMING and larger
    setup margins: worst slow-corner setup slack -1.10 -> -0.75 ns.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
2026-10-26 Explorer: sharp at any zoom, and a scale bar
    Zoomed in, the prerendered die blurred. Once the view rests for 160 ms the
    visible part is drawn again at the zoom's own scale, skipping wires and
    cells outside it; colours stay fixed to the die. A scale bar in the
    corner gives a round number of micrometres, and the clock tree keeps its
    line width at every zoom.
    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
2026-10-26 Check the timing unit against a reference model in make sim
    make syncref: test/sync_model.py replays a random 60,000-clock trace from
    test/tb_sync_ref.sv (pins, Xpulse instructions, register accesses, rare
    resets, busy and quiet phases) through a Python model of the timing unit
    and compares every output on every clock, for three builds: Tiqora,
    Tiqora-Serial and a 4-channel stress build with the glitch filter on.
    Both files are shared byte for byte with Tiqora-Serial and are in
    docs/shared_timing.sha256 (now 7 files). make shared prints the count
    from the manifest instead of a fixed 5.
    Mutants of src/sync, each caught by make syncref (10 of 10):
    deadline one tick late, overflow masked by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
2026-10-26 Stop the timing unit losing pin events without overflow
    Alek approved the small fix for the two losses the reference model
    found. Shared RTL, byte-identical with Tiqora-Serial:
    - sync_unit.sv: when a TMARK takes the queue slot, the pin event stays
    in the backlog and is queued a clock later with its own timestamp
    (hw_taken), instead of being dropped. A new edge that replaces a
    waiting backlog (edges on several pins in one clock are queued one
    per clock) now raises overflow through the queue's new `lost` input.
    - sync_event_fifo.sv: `lost` input; overflow comment corrected.
    Checks:
    - tb_unit.sv: `lost` sets overflow with the queue empty (49 -> 50).
    - sync_model.py follows the new beh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
    [tb_unit.sv]
2026-10-27 Report routed timing for the RTL with the event-loss fix
    Local LibreLane 3.0.14 run of src/config.json at 3x2 on this branch
    (2026-10-27): route DRC 0, Magic DRC 0, LVS 0, antenna 0, utilisation
    61%. Setup +6.87 ns typical, -0.98 ns nom_ss (37 paths), -1.52 ns
    max_ss (51 paths); hold met everywhere (worst +0.10 ns, fast corner).
    The worst paths run pc -> boot ROM -> QSPI read-data register, not
    through the timing unit; the fix's 52 extra cells moved placement and
    the slack with it (previous run on the RTL before the fix: -0.75 ns).
    Alek accepted the slow-corner rating instead of more timing work; the
    docs now give about 46 MHz there (an estimate from the slack: 21.5 ns),
    not 48.
    Co-Author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
2026-10-27 Re-measure on main and make every number match its report
    Re-ran on main 3684851 (2026-10-27): make sim 495 checks in 18 suites
    plus tour 15, cocotb 6/6, make act 37/37, make gl 5 pass + 1 skipped,
    make lint and make warnings clean, make area 50,965 um2 / 1,191 flip-flops
    / 6,099 cells, make timing 12.45 ns ss and 6.04 ns tt, Basys 3 sim 26
    checks, modes area 71,134 um2. GitHub run 40431523830 on main: gds,
    precheck and gl_test pass; the flow reports DRC, LVS and antenna passed.
    - README, info.md, VERIFICATION.md, HARDENING.md, MODES.md, progress.json
    and the site now cite main and that run instead of PR #4 / verify-audits.
    - Stale facts fixed: 2x2 die size (335 um) in the prose, "no rout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
2026-10-28 Print the gds run's signoff timing per corner
    LibreLane's summary in the log only names the corners that violate, and
    the run's metrics are in an artifact that cannot be fetched from where
    the docs were checked. This step prints setup and hold slack, violation
    counts and max-slew counts for every corner, plus DRC, LVS, antenna and
    utilisation, to the log and the job summary, so the docs can quote the
    GitHub run itself.
    Claude-Session: https://claude.ai/code/session_01ThWvxvgbPkZt9LfNpWtHii
2026-10-28 Also print the gds run's whole metrics.json to the log
    The per-corner table answers the timing question; the docs' layout
    tables also quote areas and cell counts, which are only in the full
    file. It goes to stderr inside a collapsed group, so the job summary
    keeps just the table.
    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
2026-10-28 Quote GitHub's own signoff timing: about 45 MHz at the slowest corner
    GitHub run 40624722131 (src/ as on main 3684851) now prints its
    metrics: setup +7.22 ns typical, -1.73 ns nom_ss, -2.30 ns max_ss on
    29 paths; hold +0.105 ns worst; DRC, LVS, antenna 0; 61% utilisation;
    max-slew warnings on 2,083 pins and max-cap on 13 nets at max_ss.
    The docs quoted -1.52 ns and about 46 MHz from a local run with a
    different OpenROAD build. They now quote GitHub's run, about 45 MHz at
    the slowest corner, and say that the 46 MHz rating accepted on
    2026-10-27 came from the local run. info.yaml's comment follows; the
    clock stays 50 MHz.
    Claude-Session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
2026-11-01 Print the slowest signoff paths in the gds job log
    Speed work needs GitHub's routed critical paths; the job log was the only
    place they can be read from.
    Claude-Session: https://claude.ai/code/session_01ThWvxsfFwEPvFsWnavHaKB
